MohammadHosseinKv/Tetris-w-Digital-Logic/(list of files, drawings)

Other design files:
Tetris_Digital_Project.pdsprj
