MohammadHosseinKv/Tetris-w-Digital-Logic/(commit log)

2024-12-28 Add block creation and controls
    [DC14031_Project.pdsprj]
2025-01-01 Add game core (Shift, score , score counter)
    All of newly added components in this commit are in Root Sheet 2 for testing before going inside multiple subcircuits.
    [DC14031_Project.pdsprj]
2025-01-01 Fix bug of game reset not functioning properly
    [DC14031_Project.pdsprj]
2025-01-05 moved newly added circuits to game core sub circuit
    All previous commit circuits in Root Sheet 2 were moved to a separate subcircuit inside the Game subcircuit, called GAME CORE.
    Also, some minor adjustments were made to the main interface.
    [DC14031_Project.pdsprj]
2025-01-23 Fix WinGame and LoseGame reset condition
    [DC14031_Project.pdsprj]
2025-01-28 optimize subcircuits
    [DC14031_Project.pdsprj]
2025-02-05 fix some defaults string positioning
    [DC14031_Project.pdsprj]
2025-02-10 rearrange some circuits wiring
    [DC14031_Project.pdsprj]
2025-02-18 fix encoder and decoder bug when handling multiple full rows
    [DC14031_Project.pdsprj]
2025-02-18 add Full Board Condition section
2025-02-23 add gameplay sample link
2025-02-23 add gameplay sample video
2025-02-23 fix gameplay sample download link
